UnknownHero99/SmartSolarHeatingProject/PCB/README.md

## PCB design
PCB is based on ESP32 and is fully suitable for usage with SSHP firmware
