UnknownHero99/SmartSolarHeatingProject/Firmware/SSHPNextion/background.png

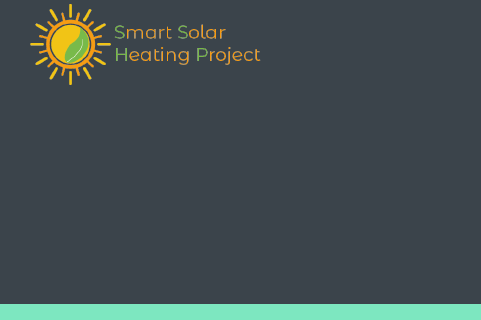
Firmware/SSHPNextion/background.png
