UnknownHero99/SmartSolarHeatingProject/Firmware/SSHPNextion/ezgif.com-resize.gif

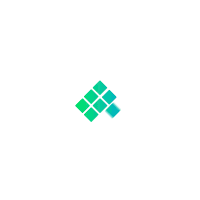
Firmware/SSHPNextion/ezgif.com-resize.gif
