UnknownHero99/SmartSolarHeatingProject/PCB/SmartSolarHeatingProject.pdf

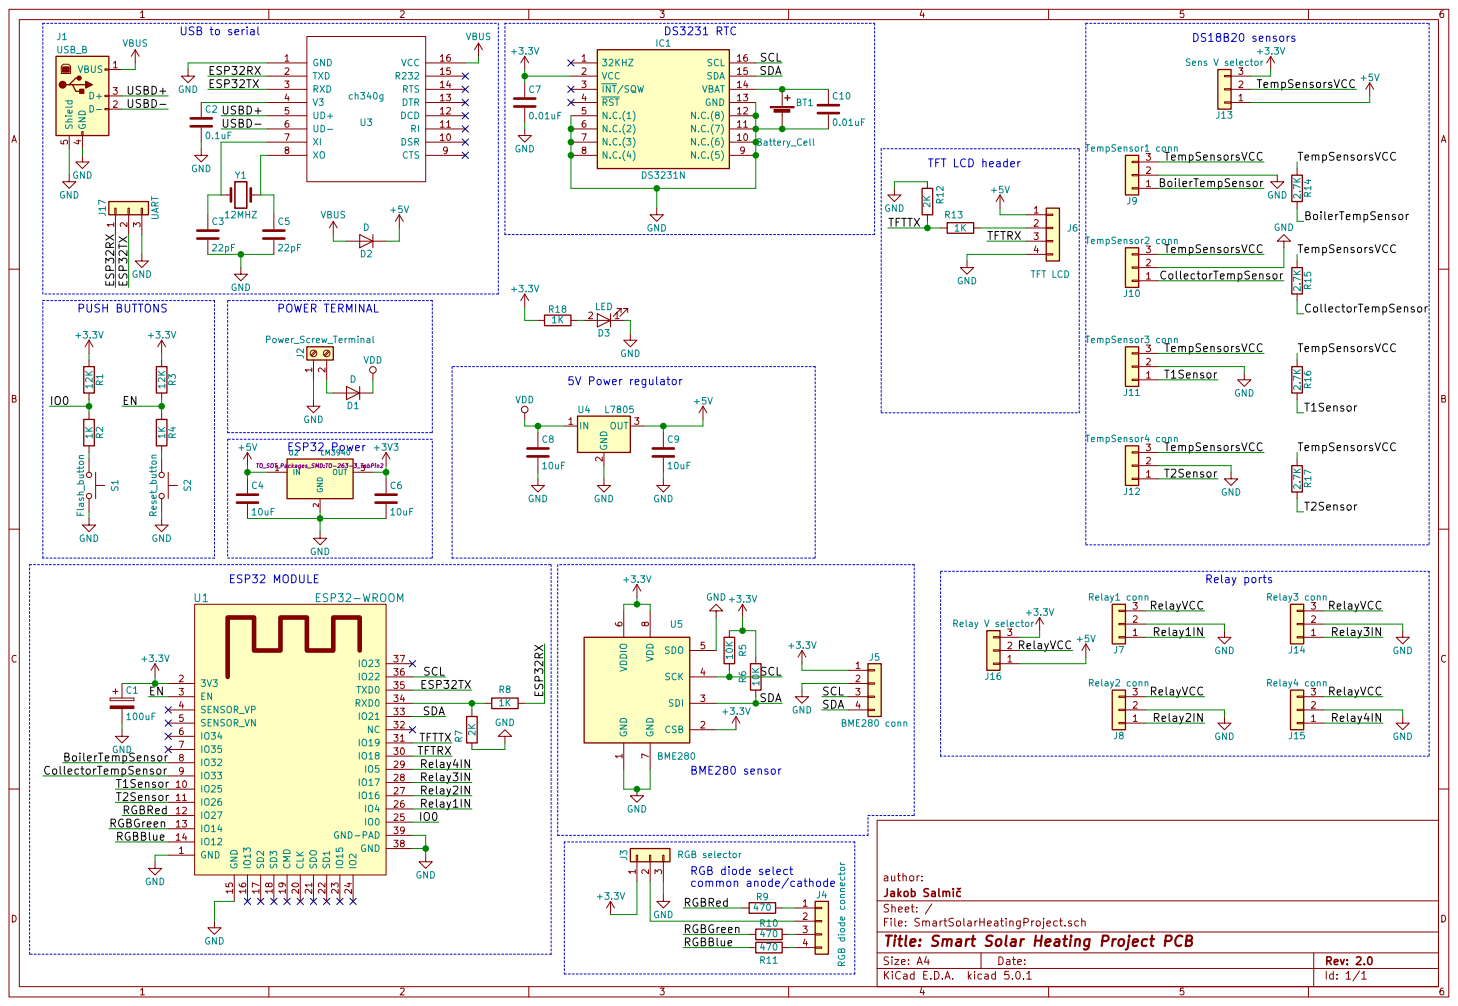
[picture p4: page 1]

J6 TFT LCD +5V GND TFT LCD header GND GND

1 CSB 2 SDI 3 SCK 4 SDO 5 VDDIO

RGB diode select
J4 RGB diode connector RGBRed
common anode/cathode

Id: 1/1 Title: Smart Solar Heating Project PCB
