UnknownHero99/SmartSolarHeatingProject/PCB/SmartSolarHeatingProject.sch

## KiCad design PCB/SmartSolarHeatingProject.sch (2019-12-29)

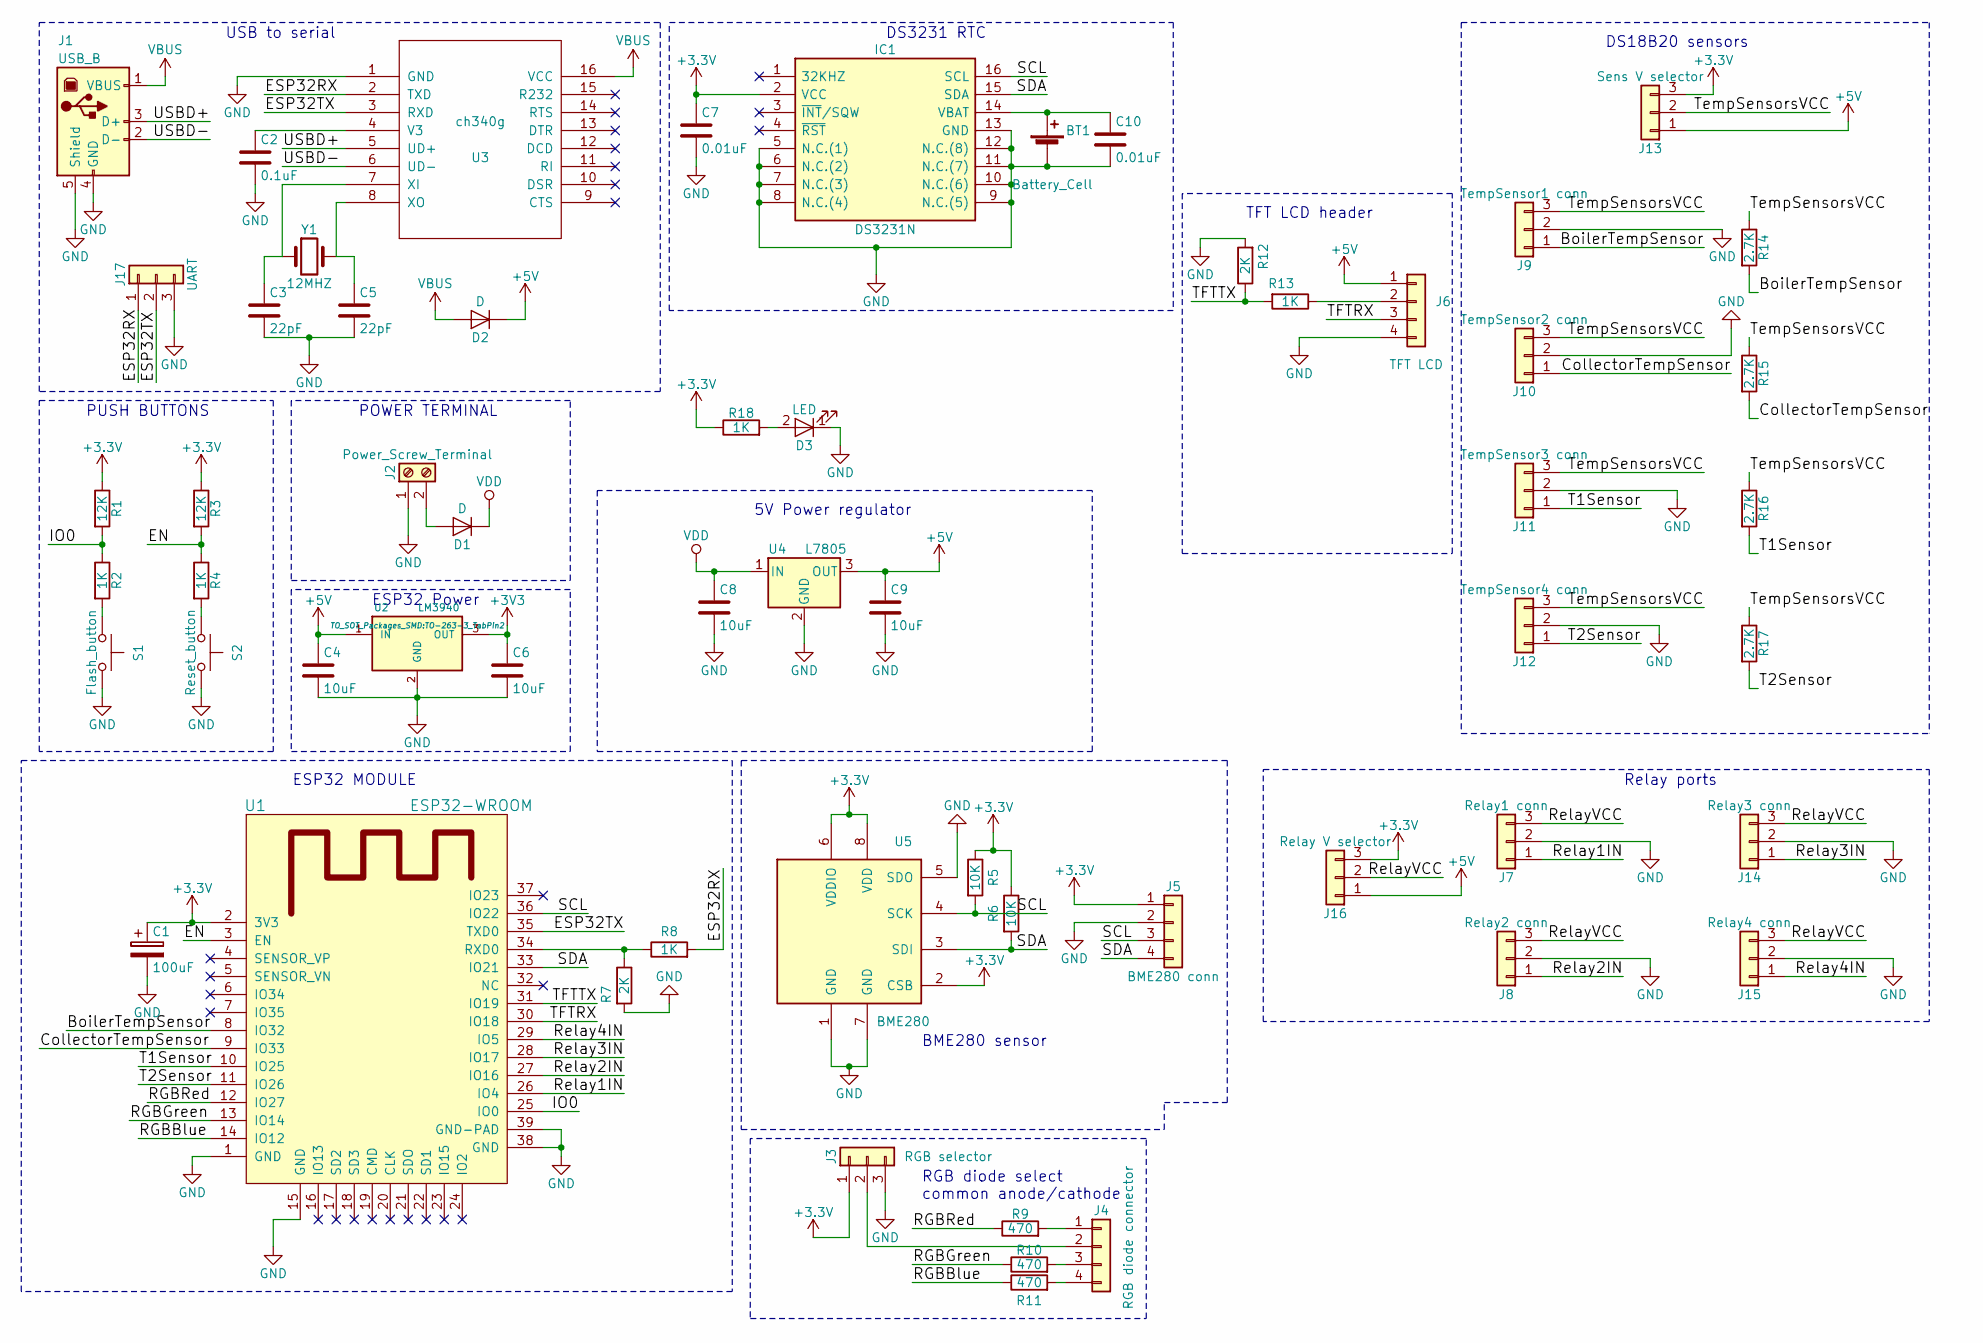
[picture p5: schematic SmartSolarHeatingProject.sch]

Parts:
BT1: Battery_Cell; Keystone_106_1x20mm-CoinCell
C1: 100uF; CP_Radial_D6.3mm_P2.50mm
C2: 0.1uF; C_0805_HandSoldering
C3, C5: 22pF; C_0805_HandSoldering
C4, C6, C8, C9: 10uF; C_0805_HandSoldering
C7, C10: 0.01uF; C_0805_HandSoldering
D1, D2: D; DO-214AC(SMA)
D3: LED; LED_0805_HandSoldering
IC1: DS3231N; SOIC127P1032X265-16N; Manufacturer_Part_Number DS3231N/DIP
J1: USB_B
J2: Power_Screw_Terminal; TerminalBlock_Pheonix_MPT-2.54mm_2pol
J3: RGB selector; Pin_Header_Straight_1x03_Pitch2.54mm
J4: RGB diode connector; Pin_Header_Straight_1x04_Pitch2.54mm
J5: BME280 conn; Socket_Strip_Straight_1x04_Pitch2.54mm
J6: TFT LCD; Socket_Strip_Straight_1x04_Pitch2.54mm
J7: Relay1 conn; Pin_Header_Straight_1x03_Pitch2.54mm
J8: Relay2 conn; Pin_Header_Straight_1x03_Pitch2.54mm
J9: TempSensor1 conn; JST_PH_B3B-PH-K_03x2.00mm_Straight
J10: TempSensor2 conn; JST_PH_B3B-PH-K_03x2.00mm_Straight
J11: TempSensor3 conn; JST_PH_B3B-PH-K_03x2.00mm_Straight
J12: TempSensor4 conn; JST_PH_B3B-PH-K_03x2.00mm_Straight
J13: Sens V selector; Pin_Header_Straight_1x03_Pitch2.54mm
J14: Relay3 conn; Pin_Header_Straight_1x03_Pitch2.54mm
J15: Relay4 conn; Pin_Header_Straight_1x03_Pitch2.54mm
J16: Relay V selector; Pin_Header_Straight_1x03_Pitch2.54mm
J17: UART; Pin_Header_Straight_1x03_Pitch2.54mm
R1, R3: 12K; R_0805_HandSoldering
R2, R4, R8, R13, R18: 1K; R_0805_HandSoldering
R5, R6: 10K; R_0805_HandSoldering
R7, R12: 2K; R_0805_HandSoldering
R9, R10, R11: 470; R_0805_HandSoldering
R14, R15, R16, R17: 2.7K; R_0805_HandSoldering
S1: Flash_button; SW_SPST_SKQG
S2: Reset_button; SW_SPST_SKQG
U1: ESP32-WROOM
U2: LM3940; TO-263-3_TabPin2
U3: ch340g; SOP-16_4.4x10.4mm_Pitch1.27mm
U4: L7805; TO-263-3_TabPin2
U5: BME280; Bosch_LGA-8_2.5x2.5mm_Pitch0.65mm_ClockwisePinNumbering
Y1: 12MHZ; Crystal_HC49-4H_Vertical

Connections:
+3.3V: C1.1, C7.1, IC1.2 (VCC), J3.1, J5.1, J13.3, J16.3, R1.1, R3.1, R5.1, R6.1, R18.1, U1.2 (3V3), U5.2 (CSB), U5.6 (VDDIO), U5.8 (VDD)
+3V3: C6.1, U2.3 (OUT)
+5V: C4.1, C9.1, D2.1 (K), J6.1, J13.1, J16.1, U2.1 (IN), U4.3 (OUT)
BoilerTempSensor: J9.1, R14.2, U1.8 (IO32)
CollectorTempSensor: J10.1, R15.2, U1.9 (IO33)
EN: R3.2, R4.1, U1.3 (EN)
ESP32RX: J17.1, R8.2, U3.2 (TXD)
ESP32TX: J17.2, U1.35 (TXD0), U3.3 (RXD)
GND: BT1.2 (-), C1.2, C2.2, C3.2, C4.2, C5.2, C6.2, C7.2, C8.2, C9.2, C10.2, D3.1 (K), IC1.5 (N.C.(1)), IC1.6 (N.C.(2)), IC1.7 (N.C.(3)), IC1.8 (N.C.(4)), IC1.9 (N.C.(5)), IC1.10 (N.C.(6)), IC1.11 (N.C.(7)), IC1.12 (N.C.(8)), IC1.13 (GND), J1.4 (GND), J1.5 (Shield), J2.1, J3.3, J5.2, J6.4, J7.2, J8.2, J9.2, J10.2, J11.2, J12.2, J14.2, J15.2, J17.3, R7.2, R12.2, S1.2, S2.2, U1.1 (GND), U1.15 (GND), U1.38 (GND), U1.39 (GND-PAD), U2.2 (GND), U3.1 (GND), U4.2 (GND), U5.1 (GND), U5.5 (SDO), U5.7 (GND)
IO0: R1.2, R2.1, U1.25 (IO0)
unnamed: BT1.1 (+), C10.1, IC1.14 (VBAT)
unnamed: C2.1, U3.4 (V3)
unnamed: C3.1, U3.7 (XI), Y1.1
unnamed: C5.1, U3.8 (XO), Y1.2
unnamed: D1.2 (A), J2.2
unnamed: D3.2 (A), R18.2
unnamed: J3.2, J4.2
unnamed: J4.1, R9.2
unnamed: J4.3, R10.2
unnamed: J4.4, R11.2
unnamed: J6.2, R13.1
unnamed: R2.2, S1.1
unnamed: R4.2, S2.1
unnamed: R7.1, R8.1, U1.34 (RXD0)
RGBBlue: R11.1, U1.14 (IO12)
RGBGreen: R10.1, U1.13 (IO14)
RGBRed: R9.1, U1.12 (IO27)
Relay1IN: J7.1, U1.26 (IO4)
Relay2IN: J8.1, U1.27 (IO16)
Relay3IN: J14.1, U1.28 (IO17)
Relay4IN: J15.1, U1.29 (IO5)
RelayVCC: J7.3, J8.3, J14.3, J15.3, J16.2
SCL: IC1.16 (SCL), J5.3, R5.2, U1.36 (IO22), U5.4 (SCK)
SDA: IC1.15 (SDA), J5.4, R6.2, U1.33 (IO21), U5.3 (SDI)
T1Sensor: J11.1, R16.2, U1.10 (IO25)
T2Sensor: J12.1, R17.2, U1.11 (IO26)
TFTRX: J6.3, U1.30 (IO18)
TFTTX: R12.1, R13.2, U1.31 (IO19)
TempSensorsVCC: J9.3, J10.3, J11.3, J12.3, J13.2, R14.1, R15.1, R16.1, R17.1
USBD+: J1.3 (D+), U3.5 (UD+)
USBD-: J1.2 (D-), U3.6 (UD-)
VBUS: D2.2 (A), J1.1 (VBUS), U3.16 (VCC)
VDD: C8.1, D1.1 (K), U4.1 (IN)

Notes on the sheet:
ESP32 MODULE
PUSH BUTTONS
ESP32 Power
USB to serial
5V Power regulator
POWER TERMINAL
DS18B20 sensors
DS3231 RTC
RGB diode select common anode/cathode
Relay ports
BME280 sensor
TFT LCD header
