UnknownHero99/SmartSolarHeatingProject/(commit log)

2016-10-14 added enabled var to pump and tempsensor class, output temp is now in string, outputs Na if disabled
2016-10-14 added tempDouble function which returns temp in double if sensor is disabled it returns -127
2016-10-14 some fixes about sensors disabled now outputs on display Na if not avaliable
    [Pump.h, TempSensors.h]
2016-11-02 joined esp8266 and adruino program to one git repo, changed delay when there is problem with sd card
    [Esp8266.ino]
2016-11-02 fixed led indication when controlling from esp, now only one pump is possible to controll, need to find out how to make reference array
2016-11-02 added pumps management on esp8266
2016-11-19 fixed some problems, need to found out why there is pressure shown on every page
    [Esp8266.ino]
2016-11-26 fixed arduino ide compile error
    [Esp8266.ino, global.h]
2017-01-01 probably fixed thinkspeak, and added API to esp
    [Esp8266.ino]
2017-02-25 made some changes in communication between arduino and esp
2017-02-27 fixed communication between esp and arduino on boot
2017-02-27 added option to check esp's IP on arduino lcd
2017-02-28 improved pumps status display in webgui
2017-03-01 improved esp and arduino connection now data are real time
2017-03-02 improvement for counting pump's operating time
2017-03-03 thinkspeak zero data fix
    [Esp8266.ino, global.h]
2017-07-19 simplified conditions when pump is running
2017-08-17 Fixed OTA, Thingspeak channel ID and API key save, added option to change password
    [Esp8266.ino]
2017-09-30 Ported to ESP32
2017-10-08 fixed some bugs and implemented OTA
    [Esp32.ino]
2017-10-10 fixed some CSS bugs and made WEB GUI mobile friendly
    [Esp32.ino]
2017-11-19 implemented main functions for ESP32 platform
2017-11-20 Added anti freeze function that in case there is danger for water in collector to freeze statrs a pump for 5 minutes, improved pumps frontend-backend communication
2017-11-21 improved temp sensors readings
2019-12-29 added PCB design and reorganised
    [SmartSolarHeatingProject-2019-02-25-23-18-20.sch, SmartSolarHeatingProject-2019-02-25-23-39-57.sch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]
2021-03-09 Development (#3)
    * multi core attempt
    * sensor error handling
    * added libraries
    * dual core fix
    [Esp32.ino, TempSensors.h, WebServerHandler.h, global.h]
